MMielcarski/Morse-Flashlight/README.md

# Morse-Flashlight
Flashlight with built-in Morse code coder and decoder

Full documentation (in Polish): https://github.com/MMielcarski/Morse-Flashlight/blob/master/v_1/Documentation/morse-flashlight-1_0.pdf
