MMielcarski/Morse-Flashlight/v_2/KiCad/morse-torch_v2/images/before-tracks-1_3.png

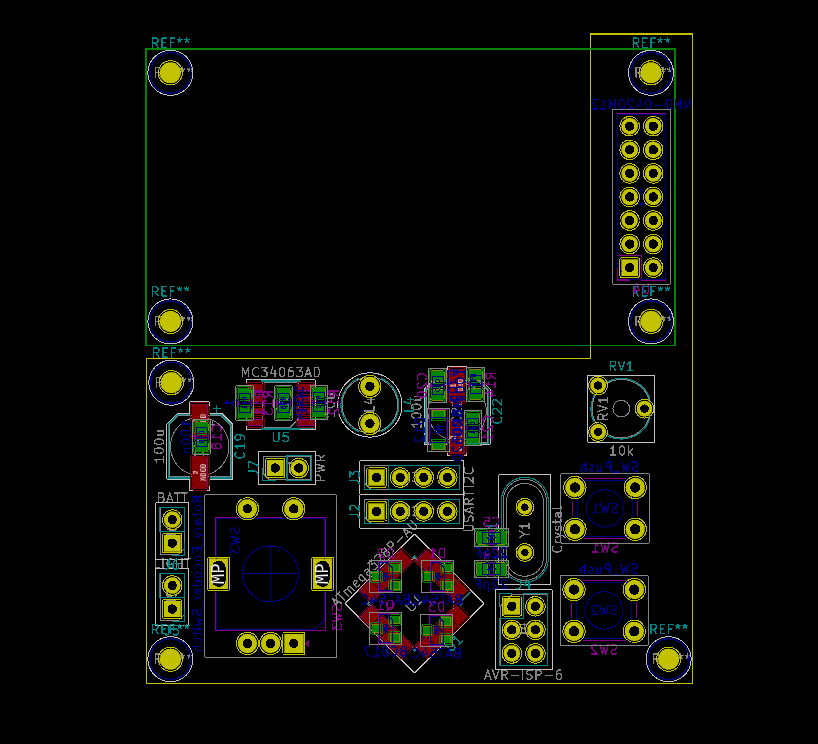
v_2/KiCad/morse-torch_v2/images/before-tracks-1_3.png
