MMielcarski/Morse-Flashlight/v_2/KiCad/morse-torch_v2/images/opamp-schem-1.png

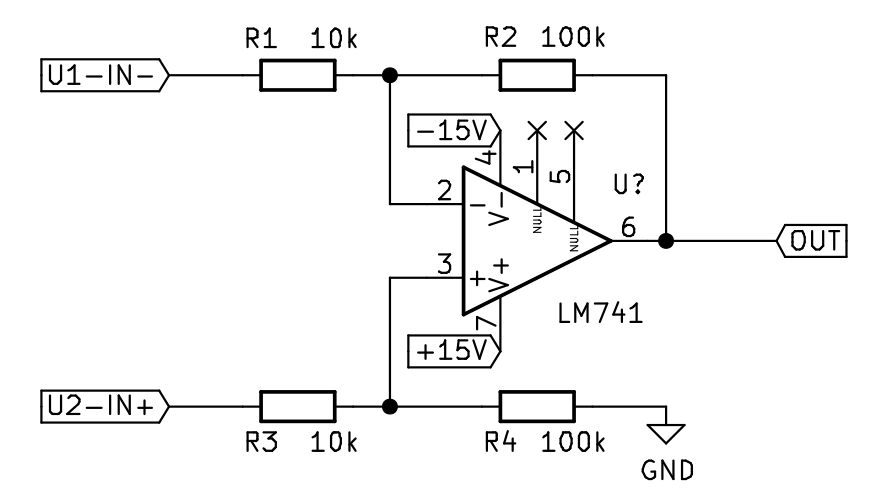
v_2/KiCad/morse-torch_v2/images/opamp-schem-1.png
