MMielcarski/Morse-Flashlight/v_2/KiCad/morse-torch_v2/pcb-pdf/Screenshot from 2018-12-09 23-39-59.png

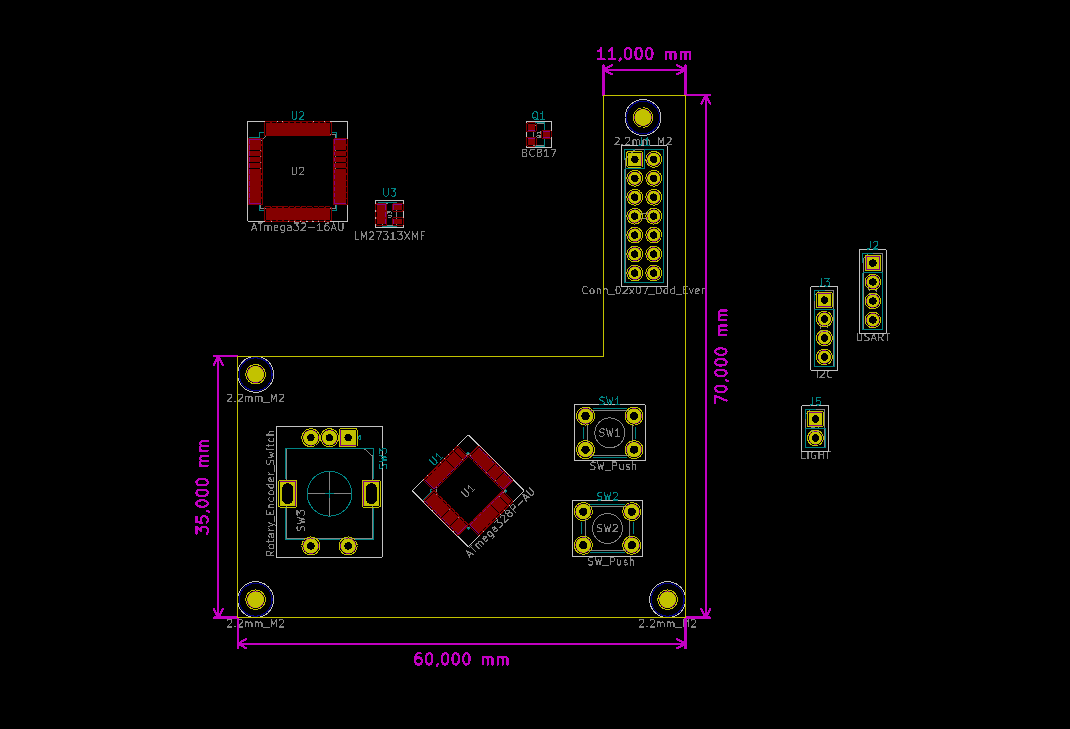
v_2/KiCad/morse-torch_v2/pcb-pdf/Screenshot from 2018-12-09 23-39-59.png
