MMielcarski/Morse-Flashlight/v_2/Calculations.ods

Sheet: BOM
part | name | voltage | amperage | price | amount | purpose
Schottkey diode | BAT54C | 30V | 0,2A | 0,10 |  | interrupt buttons
Schottkey diode | 10BQ040PBF40V |  | 1A | 0,89 |  | Step-up inductor
NPN transistor | BC817-25 |  | 0.5A | 0,27 |  | light switch
Step-up converter | LM2704MF-ADJ | 2.2-7Vin; 20Voutmax | 0.55A | 11,00 |  | power supply from Li-Ion
Step-up converter | MC34063 | 1,25-38Vin | 1,5A | 0,79 | 1

Sheet: requirements
min/max Requirements and expectations
Vin = | 2-9 | V | easy to read and modify step-up converter
load (light source) | 2-9 | V | compatible with all of the PRL flashlight models
max load | 0,5 | A | all user input with interrupts
 |  |  | user configuration save to eeprom
