MMielcarski/Morse-Flashlight/v_1/Documentation/latex/img/latarka_1.pdf

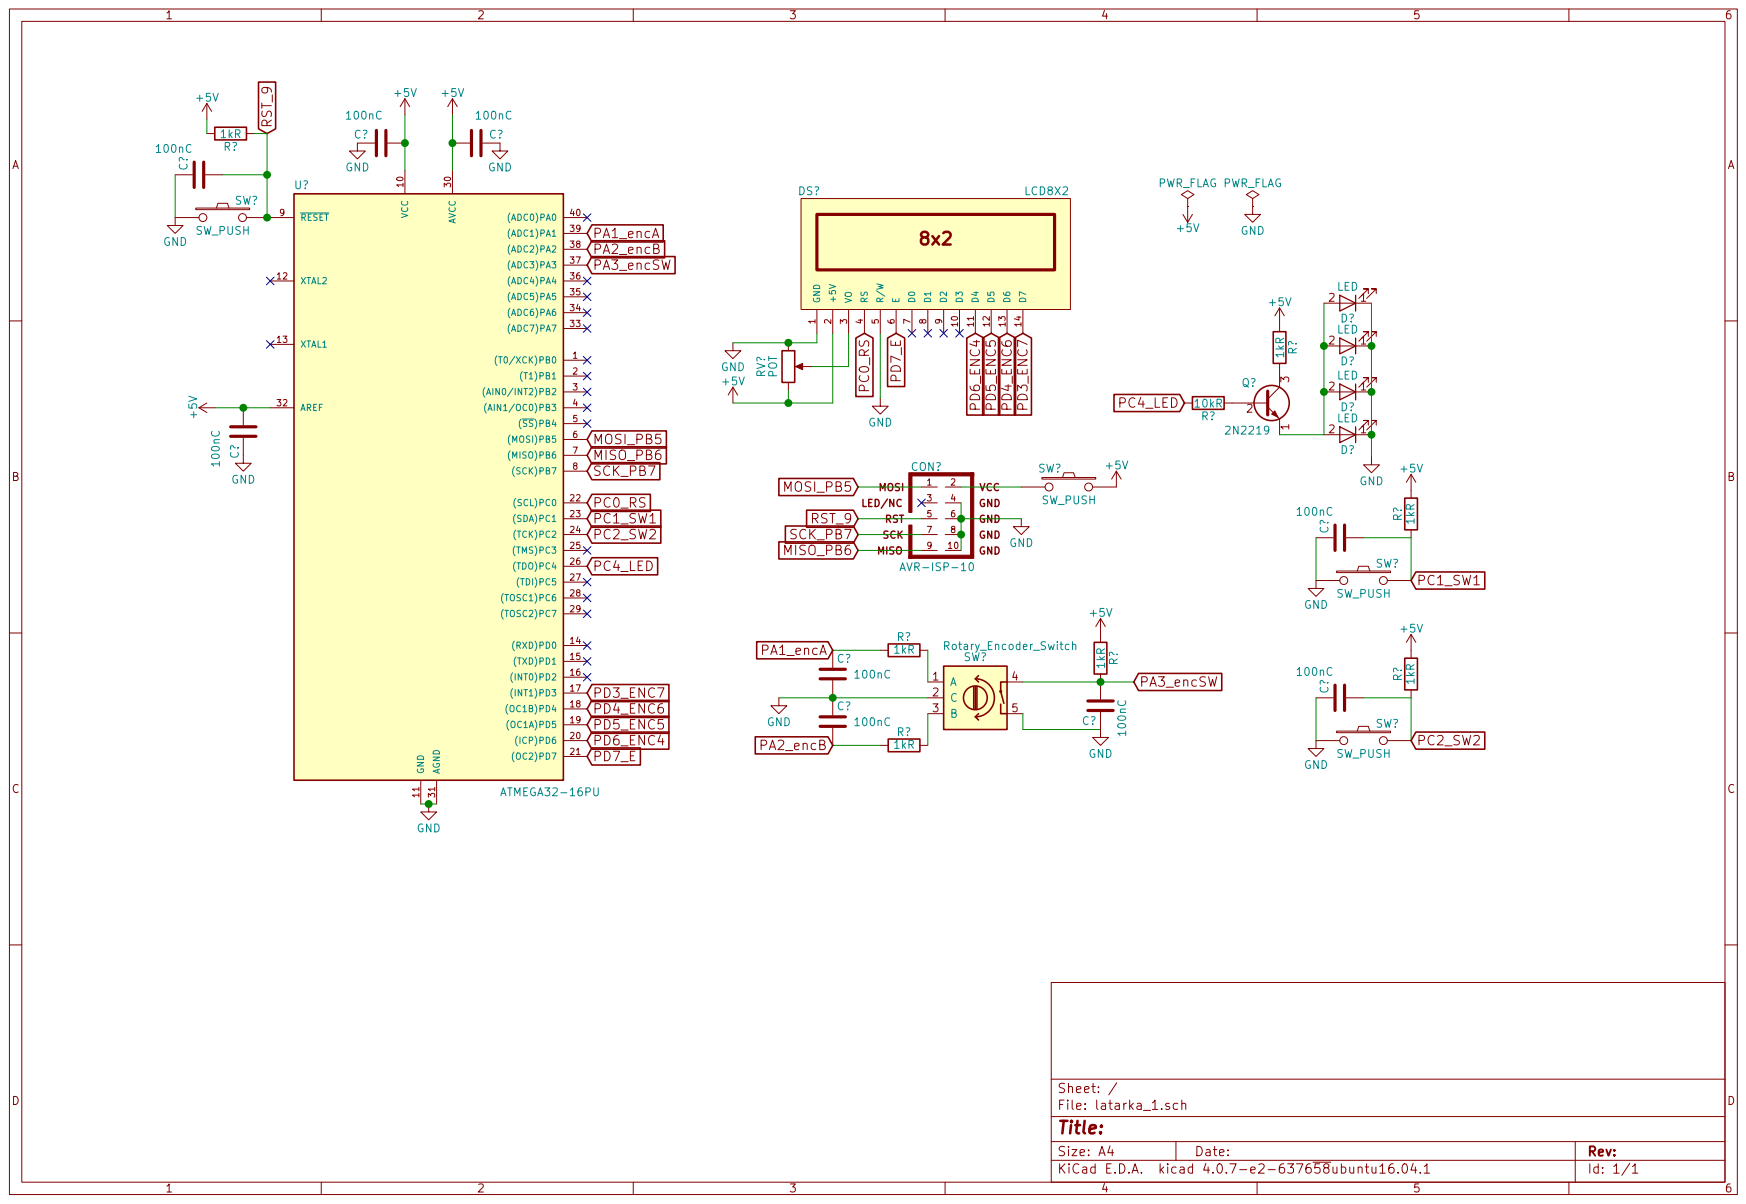
[picture p11: page 1]
