MMielcarski/Morse-Flashlight/v_2/KiCad/morse-torch_v2/morse-torch_v2.kicad_pcb

## KiCad design v_2/KiCad/morse-torch_v2/morse-torch_v2.kicad_pcb (2019-02-24)

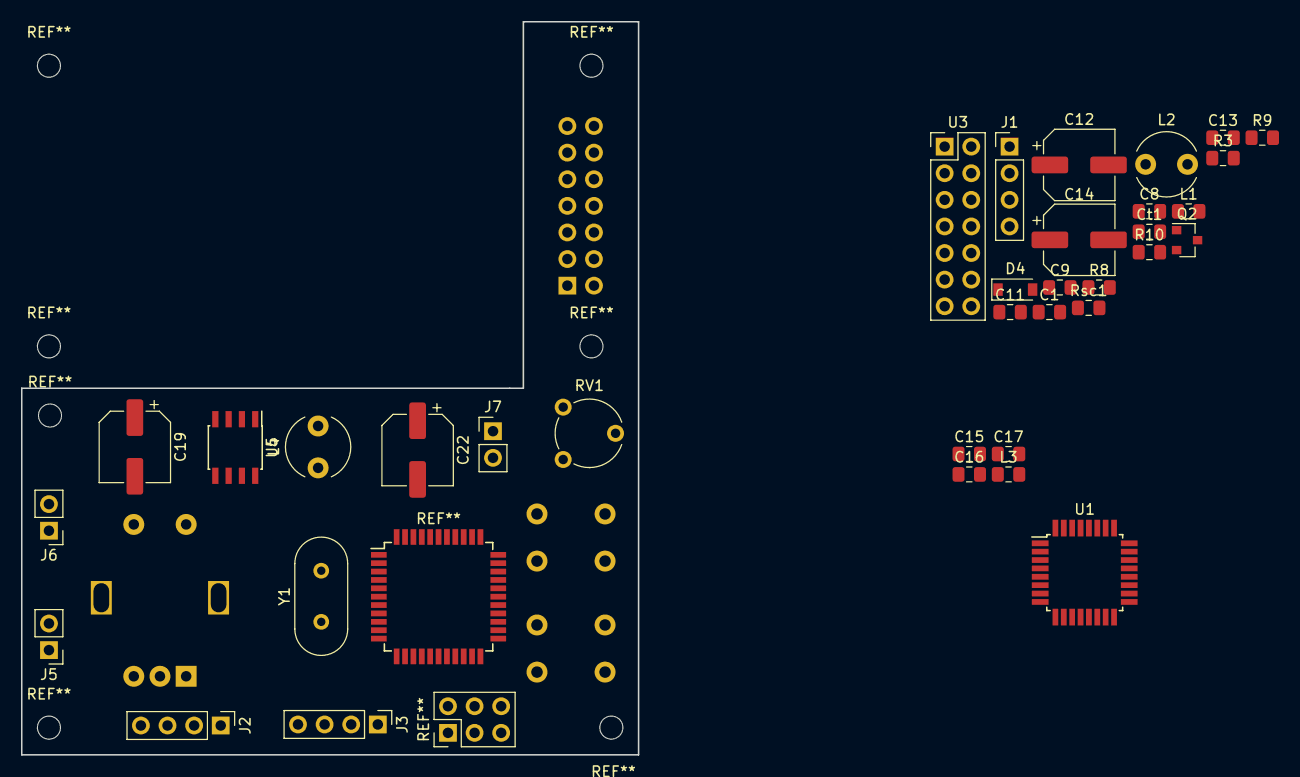
[picture p12: board morse-torch_v2.kicad_pcb from above]

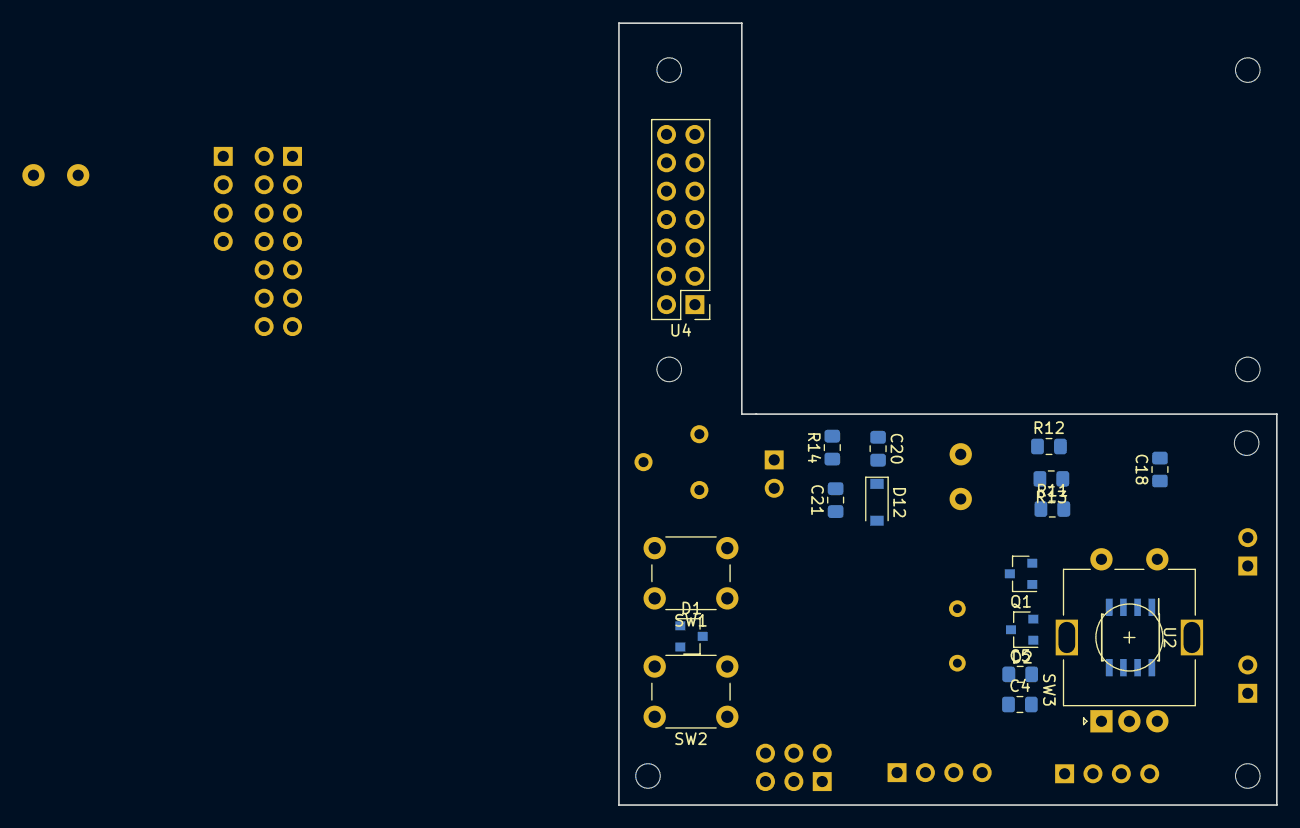
[picture p13: board morse-torch_v2.kicad_pcb from below]

Board: 2 copper layers, 58.9 x 70.0 mm, 53 parts (18 on the bottom side), 42 nets, no tracks yet.

Parts:
C1, C4, C5, C15, C16, C17: 100nF; C_0805_2012Metric_Pad1.15x1.40mm_HandSolder
C8, C9: 22pF; C_0805_2012Metric_Pad1.15x1.40mm_HandSolder
C11, C13, C18, C21: 100n; C_0805_2012Metric_Pad1.15x1.40mm_HandSolder
C12, C14, C19, C22: 100u; CP_Elec_6.3x5.4
C20: 470p; C_0805_2012Metric_Pad1.15x1.40mm_HandSolder
Ct1: 470p; C_0805_2012Metric_Pad1.15x1.40mm_HandSolder
D1, D2: BAT54C; SOT-23
D4, D12: MBR0520; D_SOD-123
J1: USART; PinHeader_1x04_P2.54mm_Vertical
J2: AVR-ISP-6; PinHeader_1x04_P2.54mm_Vertical
J3: I2C; PinHeader_1x04_P2.54mm_Vertical
J5: LIGHT; PinHeader_1x02_P2.54mm_Vertical
J6: PWR; PinHeader_1x02_P2.54mm_Vertical
J7: Microsemi_FlashPro-JTAG-10; PinHeader_1x02_P2.54mm_Vertical
L1, L3: 10uH; L_0805_2012Metric_Pad1.15x1.40mm_HandSolder
L2: 82u; L_Radial_D6.0mm_P4.00mm
L4: 10u; L_Radial_D6.0mm_P4.00mm
Q1, Q2: BC817; SOT-23
R3, R11: 10k; R_0805_2012Metric_Pad1.15x1.40mm_HandSolder
R8: 130k; R_0805_2012Metric_Pad1.15x1.40mm_HandSolder
R9, R13, R14: 100k; R_0805_2012Metric_Pad1.15x1.40mm_HandSolder
R10: 390k; R_0805_2012Metric_Pad1.15x1.40mm_HandSolder
R12: 33k; R_0805_2012Metric_Pad1.15x1.40mm_HandSolder
RV1: 10k; Potentiometer_Piher_PT-6-V_Vertical
Rsc1: 1; R_0805_2012Metric_Pad1.15x1.40mm_HandSolder
SW1, SW2: SW_Push; SW_PUSH_6mm
SW3: Rotary_Encoder_Switch; RotaryEncoder_Alps_EC11E-Switch_Vertical_H20mm
U1: ATmega328P-AU; TQFP-32_7x7mm_P0.8mm
U2: 24LC128; SOIC-8_3.9x4.9mm_P1.27mm
U3: NHD-0420H1Z; PinHeader_2x07_P2.54mm_Vertical
U4: MC34063AD; PinHeader_2x07_P2.54mm_Vertical
U5: ATmega32-16AU; SOIC-8_3.9x4.9mm_P1.27mm
Y1: Crystal; Crystal_HC49-U_Vertical

Connections:
5V-converter: C21.1, C22.2, D12.1, R14.2
+5V: C4.1, C16.1, J1.2, J2.2, J3.2, L1.1, L3.1, R3.1, R11.1, RV1.3, U1.4, U1.6, U1.18, U2.8, U3.2, U5.5
ADC0: C18.1, C19.2, J5.2, J6.2, U1.23
BUTTON_1: D1.1, SW2.2, U1.12
BUTTON_2: D1.2, SW1.2, U1.13
ENC_A: D2.2, U1.14
ENC_B: D2.1, U1.22
ENC_BUTTON: SW3.S1, U1.19
GND: C1.1, C4.2, C5.2, C8.2, C9.2, C11.2, C12.1, C13.2, C14.1, C15.1, C16.2, C17.2, C18.2, C19.1, C20.2, C21.2, C22.1, Ct1.2, J1.1, J3.1, Q1.2, Q2.2, R8.1, R12.1, RV1.1, SW1.1, SW2.1, SW3.C, SW3.S2, U1.3, U1.5, U1.21, U2.4, U3.1, U3.5, U4.2, U4.4
LCD_DATA4: U1.2, U3.11
LCD_DATA5: U1.9, U3.12
LCD_DATA6: U1.10, U3.13
LCD_DATA7: U1.11, U3.14
LCD_E: U1.25, U3.6
LCD_RS: U1.26, U3.4
MISO: J2.1, U1.16
MOSI: J2.4, U1.15
unnamed: C1.2, U1.20
unnamed: C5.1, L1.2
unnamed: C11.1, C12.2, J6.1, Rsc1.2, U4.6
unnamed: C17.1, L3.2
unnamed: Ct1.1, U4.3
unnamed: D1.3, D2.3, U1.32
unnamed: D4.2, L2.2, U4.1
unnamed: D12.2, L4.2
unnamed: J5.1, Q2.3
unnamed: L2.1, R9.1, Rsc1.1, U4.7
unnamed: L4.1, R13.1
unnamed: R9.2, U4.8
unnamed: R8.2, R10.1, U4.5
unnamed: R12.2, R14.1
unnamed: RV1.2, U3.3
RESET: R3.2, R11.2, U1.29, U5.4
RXD: J1.4, U1.30
SCK: J2.3, U1.17
SCL: J3.4, U1.28, U2.6
SDA: J3.3, U1.27, U2.5
TXD: J1.3, U1.31
Uout=+5V: C13.1, C14.2, D4.1, R10.2
XTAL1: C8.1, U1.7, U5.8, Y1.1
XTAL2: C9.1, U1.8, U5.7, Y1.2
write-protection: U1.1, U2.7
