MMielcarski/Morse-Flashlight/(commit log)

2018-04-06 kicad schematic
    [latarka_1.kicad_pcb, latarka_1.sch]
2018-04-10 dir structure change and src files replacement for up to date version with broadcast speed change feature
    [latarka_1.kicad_pcb, latarka_1.sch]
2018-04-13 latex documentation and photos
    [latarka_1.sch]
2018-04-15 documentatin v. 1.0 ready for printing
2018-05-23 latex code display enchancement with minted package
    [latarka_1.kicad_pcb]
2018-12-08 morse-torch v2 initial commit
    [Calculations.ods, latarka_1-2018-09-06-14-43-55.sch, latarka_1.sch, morse-torch_v2.kicad_pcb, morse-torch_v2.sch]
2018-12-15 started pcb design, step-up converter needs approval
    [Calculations.ods, morse-torch_v2.sch]
2019-02-24 changed uc to atmega32, added jtag interface, roughly set up final layout
    [Calculations.ods, _saved_morse-torch_v2.sch, morse-torch_v2.csv, morse-torch_v2.kicad_pcb, morse-torch_v2.sch]
